zemli777/light_sun/README.md

# Симулятор освещения планеты
Выполнен на платформе arduino

## 
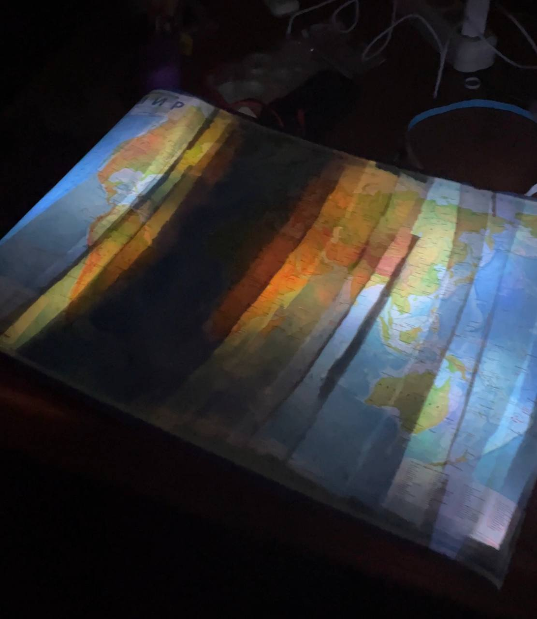
[picture p1: img/msg553971254-760434.jpg]
