zemli777/light_sun/skhema_funktsionalnaya_3_1 (1).pdf

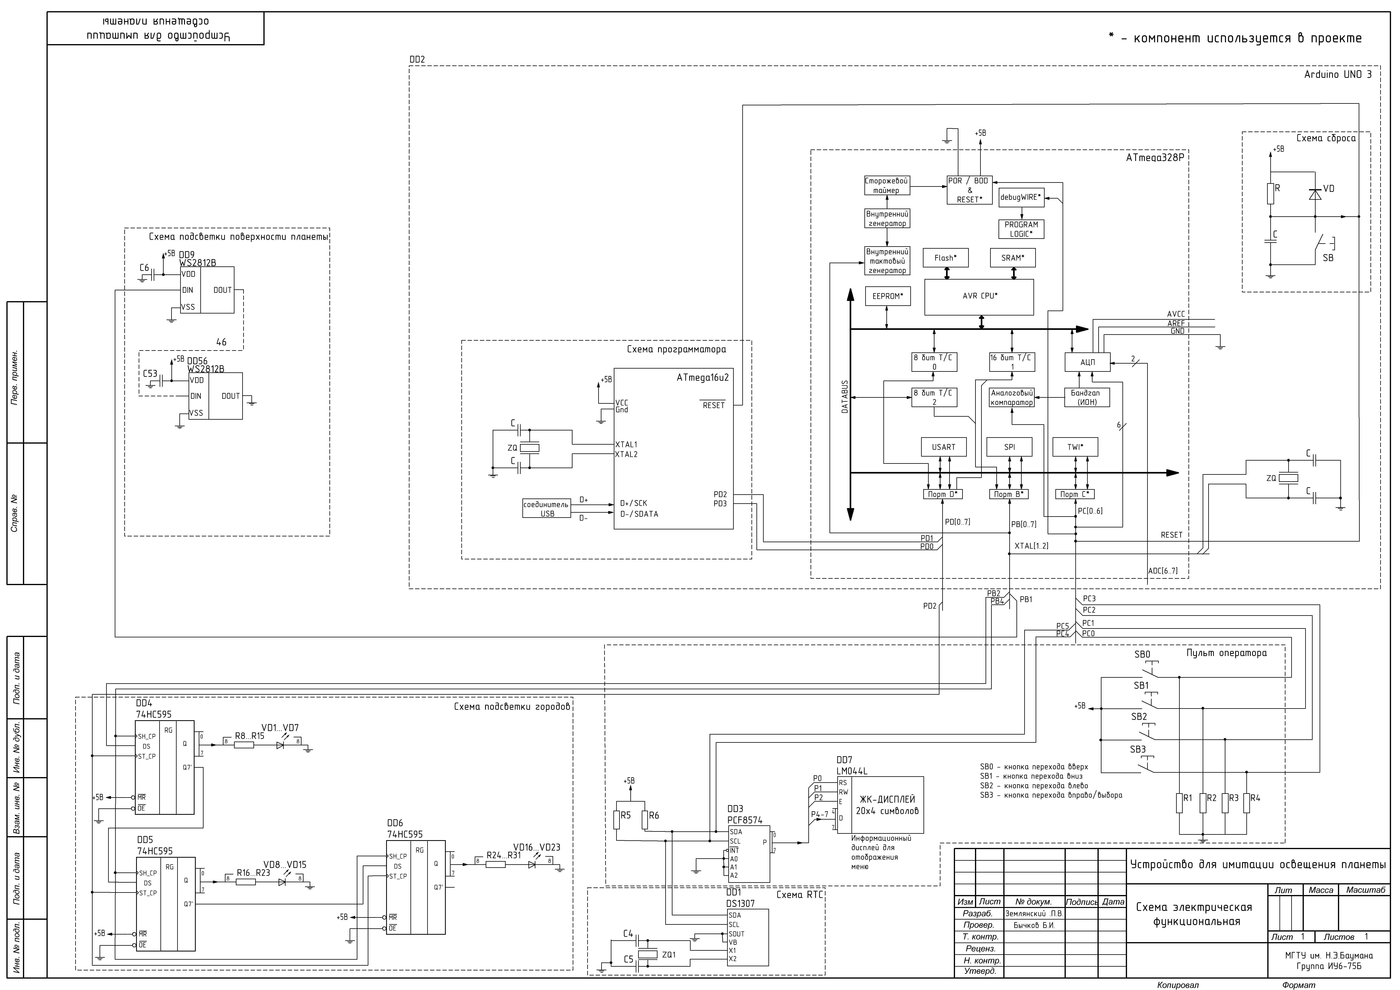
[picture p2: page 1]
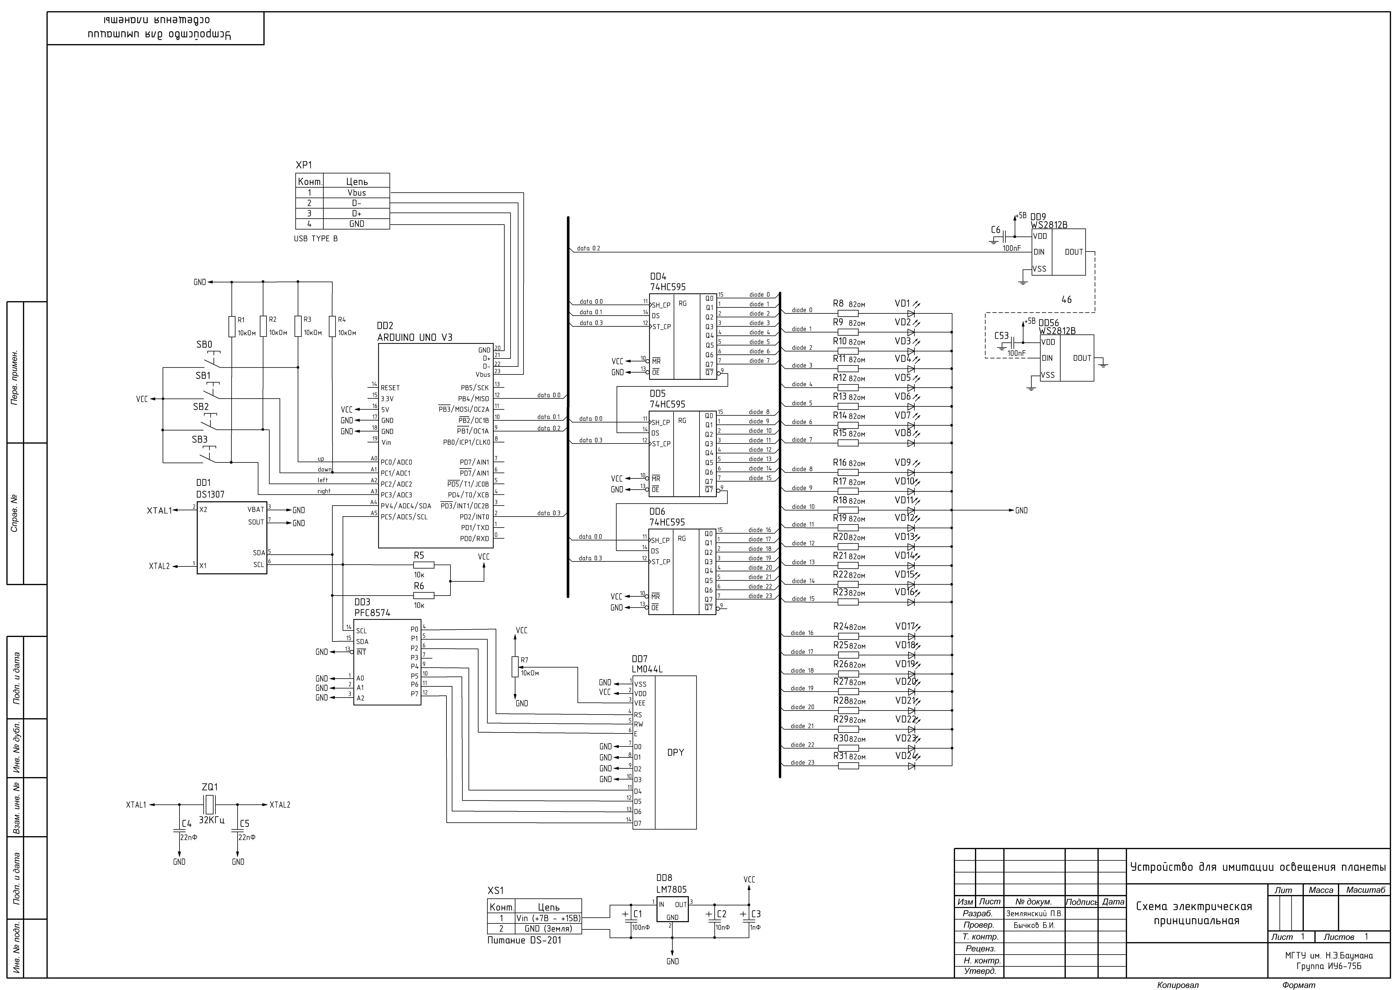
[picture p3: page 2]
