zemli777/light_sun/Перечень_элементов2.pdf

Поз.

### обозначение

Наименование | Кол. | Примечание

Схемы интегральные

DD1 | DS1307 | 1
DD2 | ARDUINO UNO | 1
DD3 | PCF8574 | 1
DD4-DD6 | 74HC595 | 3
DD7 | LM044L | 1
DD8-DD55 | WS2812B | 48
C1,C6-C53 | CC-100 100пФ | 49
C2 | CC-10 10пФ | 1
C3 | CC-1 1пФ | 1
C4-C5 | CC-22 22пФ | 2

Конденсаторы электрические

Резисторы

Подп. и дата

R1-R7 | 16K1-10C10K 10кОм | 8
R8-R31 | CF-100 82Ом | 24

Диоды

VD1-VD24 | VAOL-5LWY4 | 24
Взам. инв. № Инв. № дубл.
| Коммутационные устройства
SB1-SB4 | KAN0653-0431B | 4

## Устройство для имитации освещения планеты

Подп. и дата

Изм. | Лист | № докум | Подпись | Дата
| | Разраб. | Землянский П.В. | | Перечень элементов | Литера Группа ИУ6-75Б Н. контр. | Лист | Листов
Пров. | Бычков Б.И. | | | | Т | | 1 | 2

Инв. № подл

Утв.

МГТУ им. Н.Э. Баумана
