zemli777/light_sun/(list of files, drawings)

Other design files:
test_rtm.pdsprj
